CalceusHealth/sensor-skins-firmware/imports/alex_jira_duplicates/firmware/Reid Orthotic v2 Charger Mech/Charger case.step

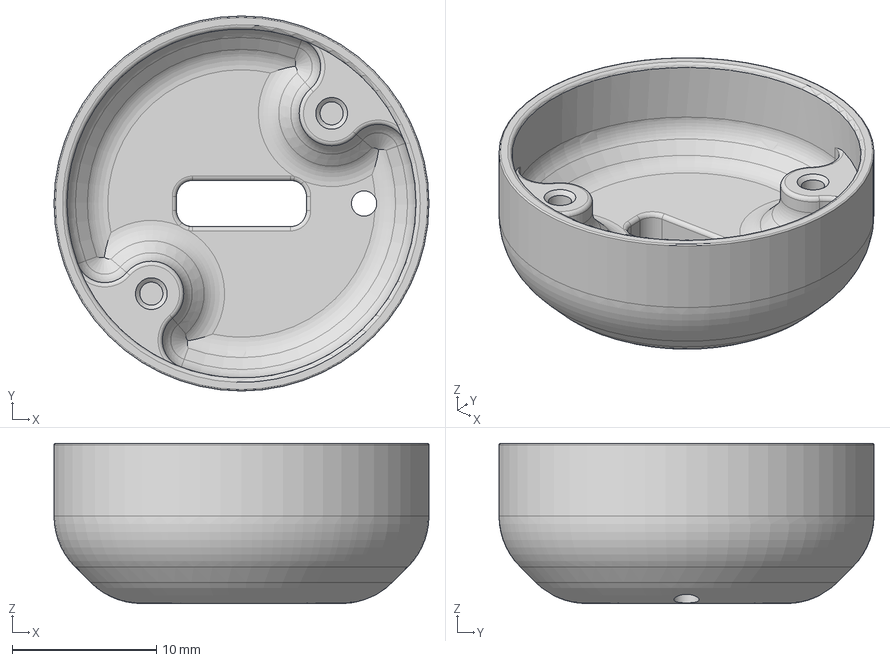
[picture p2: CAD file, 2026-04-29]
imports/alex_jira_duplicates/firmware/Reid Orthotic v2 Charger Mech/Charger case.step
26.0 x 26.0 x 11.1 mm
