CalceusHealth/sensor-skins-firmware/imports/alex_jira_duplicates/firmware/Reid Orthotic v2 Charger Mech/Charger lid.step

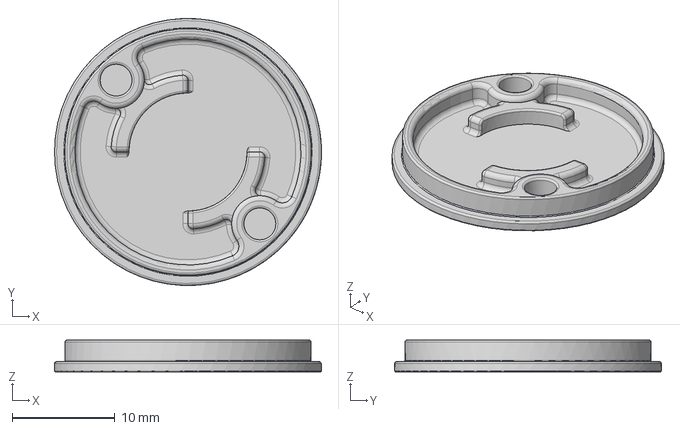
[picture p3: CAD file, 2026-04-29]
imports/alex_jira_duplicates/firmware/Reid Orthotic v2 Charger Mech/Charger lid.step
26.0 x 26.0 x 3.10 mm
