CalceusHealth/sensor-skins-firmware/(list of files, cad)

Other CAD files:
imports/alex_jira_duplicates/firmware/Reid Orthotic v2 Charger Mech/Charger case.f3d
imports/alex_jira_duplicates/firmware/Reid Orthotic v2 Charger Mech/Charger lid.f3d
