CalceusHealth/sensor-skins-firmware/artefacts/Reid Orthotic v2 R4.pdf

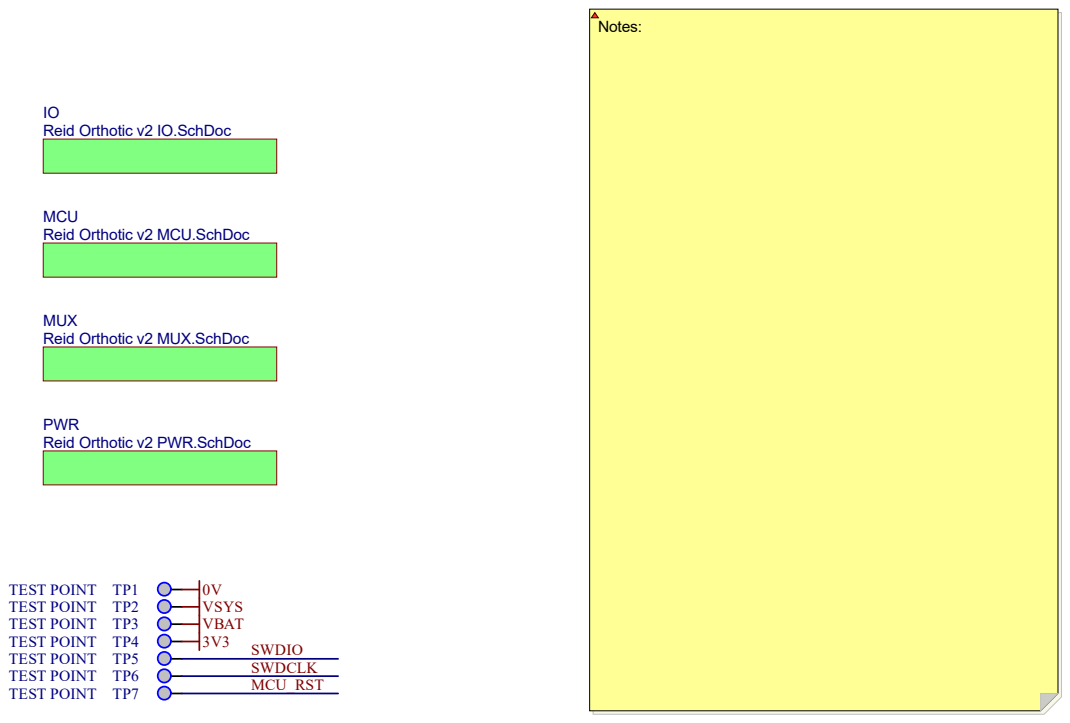
[picture p4: page 1]
Last u; ted 3/01/2024; 2Alex G; OReid Orthotic; Reid Orthotic; EST POIN; EST POIN EST POIN EST POIN EST POIN; COTP5 PITP50TP; NLMCU0RST PITP60TP; NLSWDCLK PITP50TP; NLSWDIO

CAL1020 Revision Drawn by

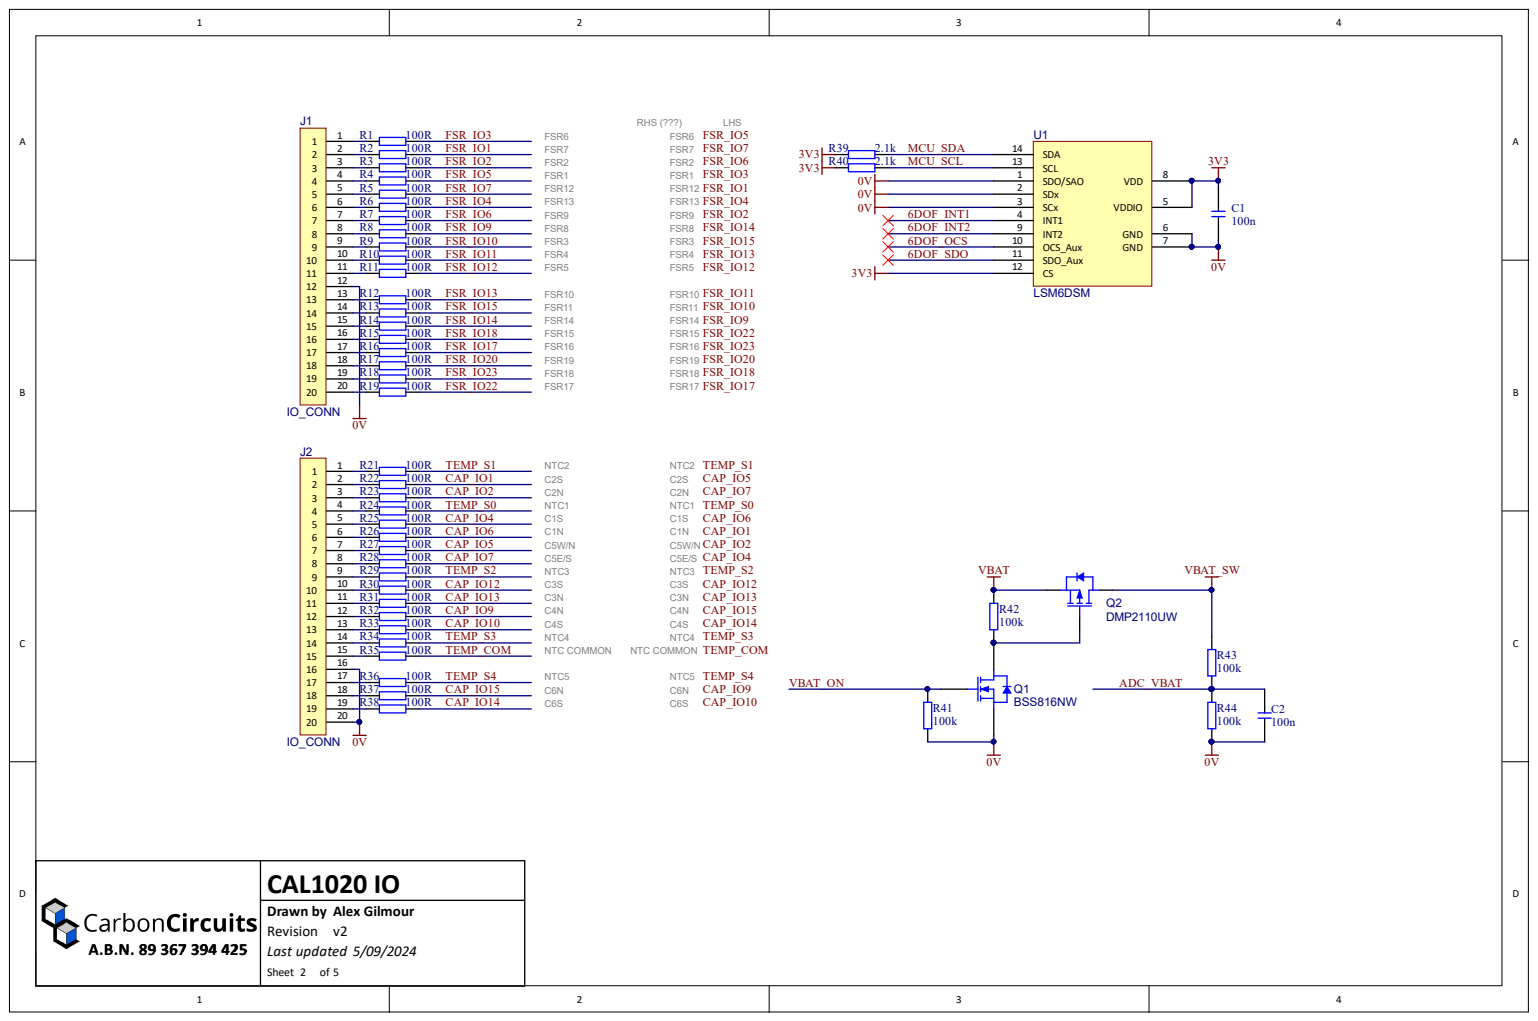
[picture p5: page 2]

CAL1020 IO Revision Drawn by

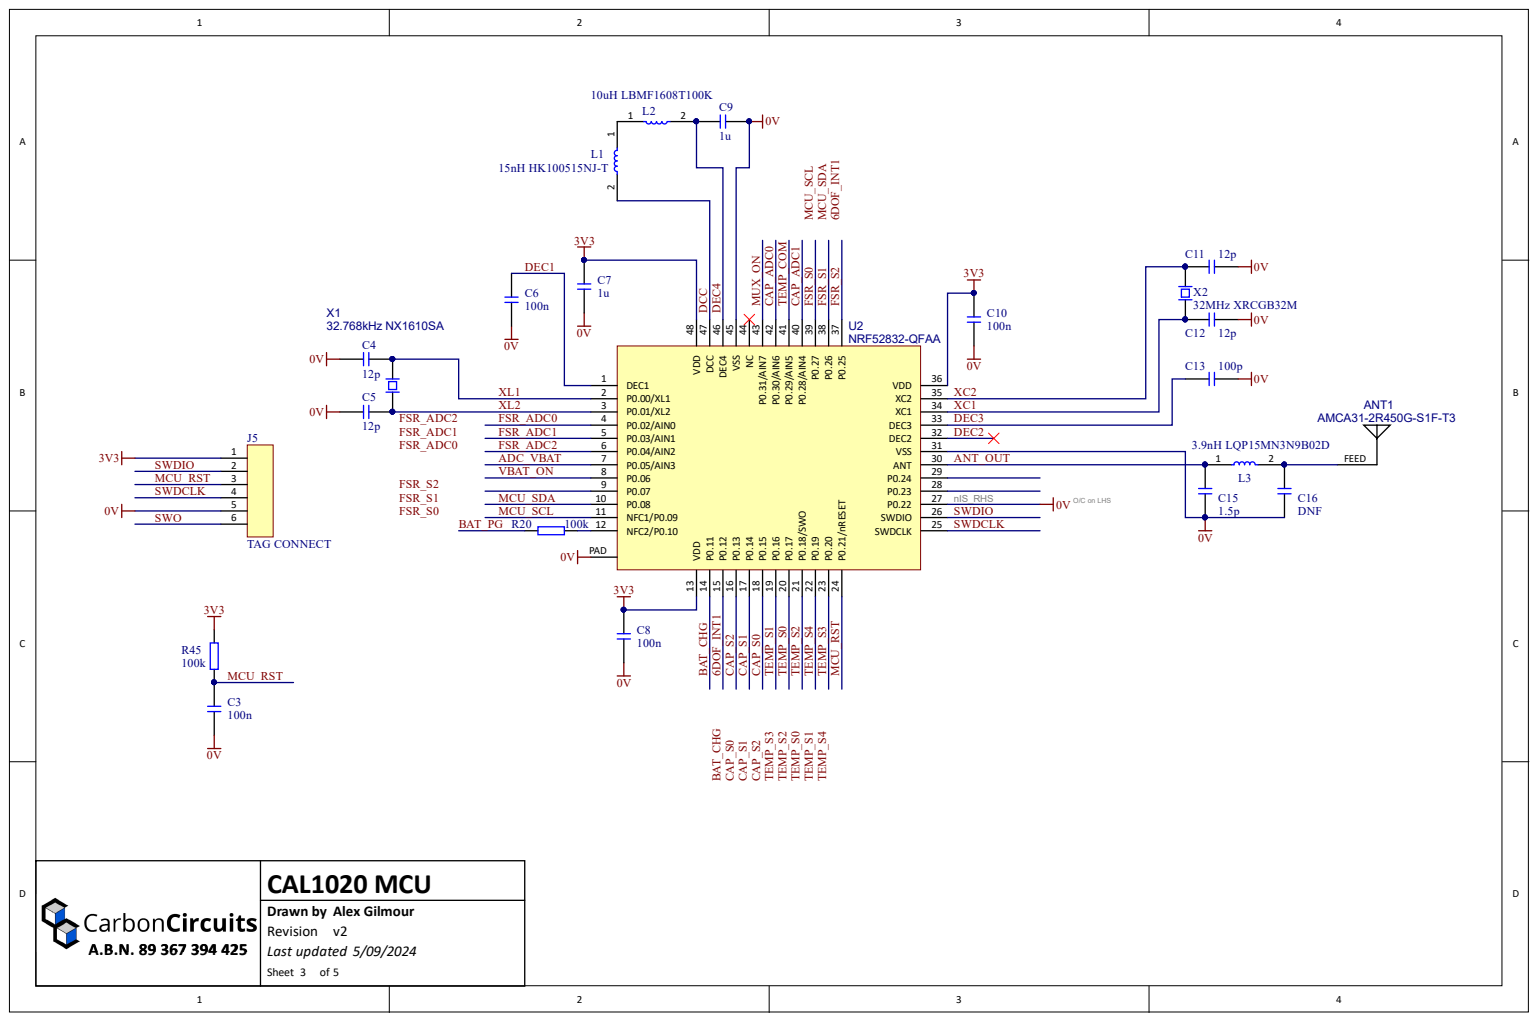
[picture p6: page 3]

0.25 37 P0.26 38 P0.27 39 P0.28/AIN4 40 P0.29/AIN5 41 P0.30/AIN6 42 P0.31/AIN7 43 NC 44 VSS 45 DEC4 46 DCC 47 VDD 48

CAL1020 MCU Revision Drawn by

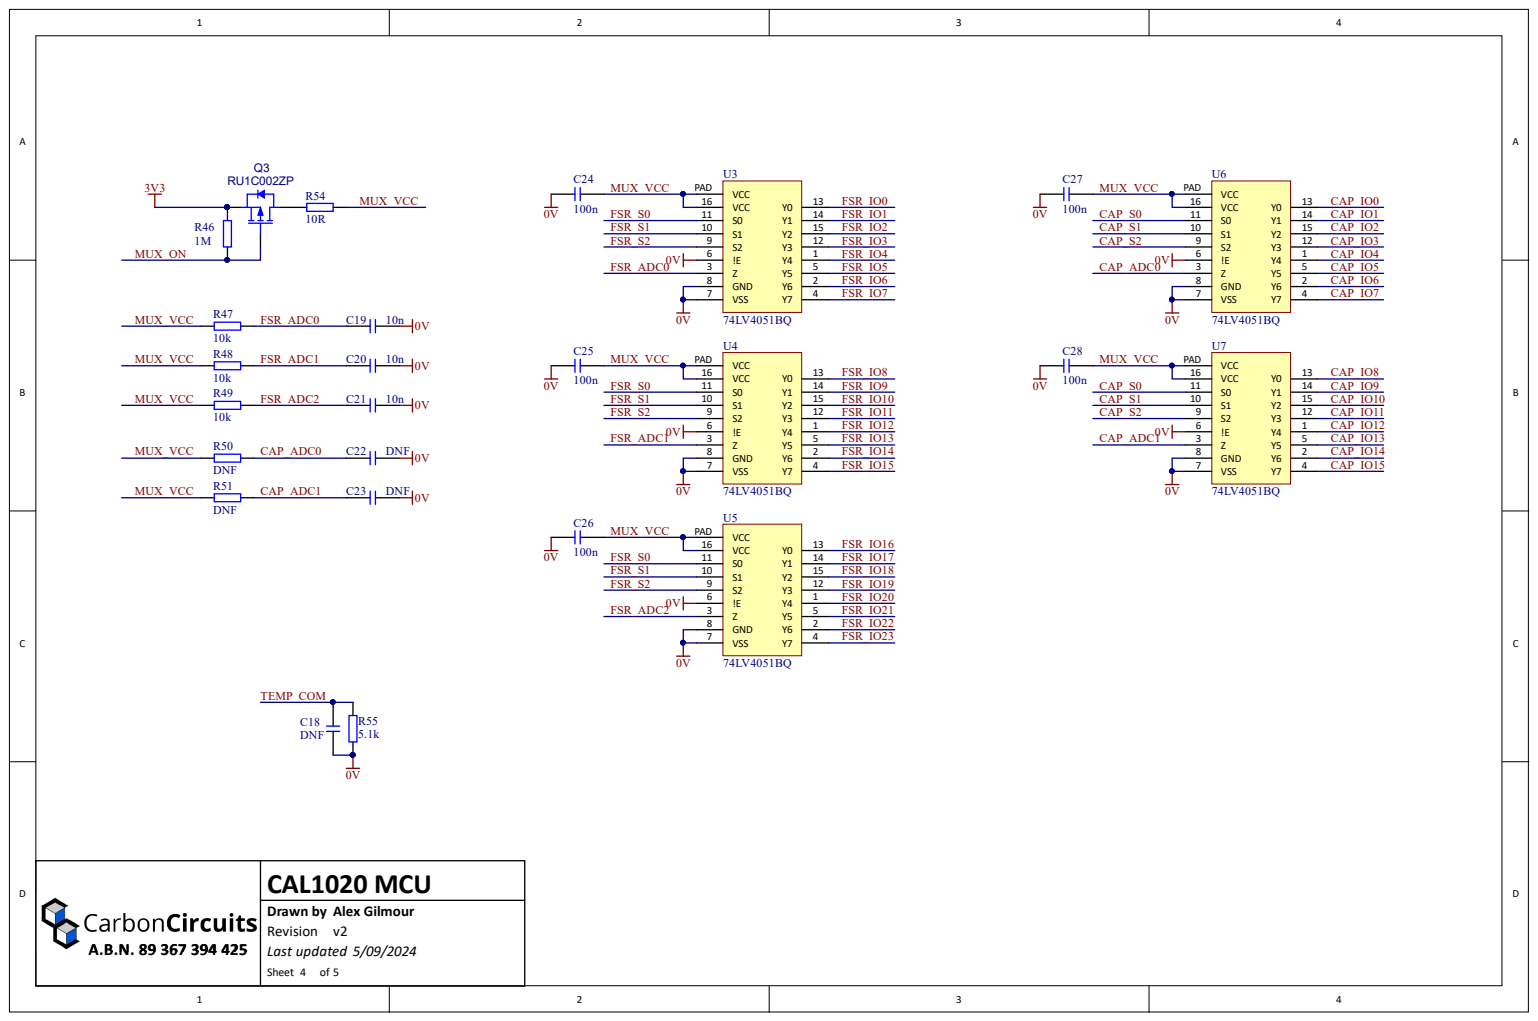
[picture p7: page 4]
Last u; ted 5/09/2024; 2Alex G; GND 8; n FSR_S0; n CAP_S0; V CAP_ADC1; DNF

CAL1020 MCU Revision Drawn by

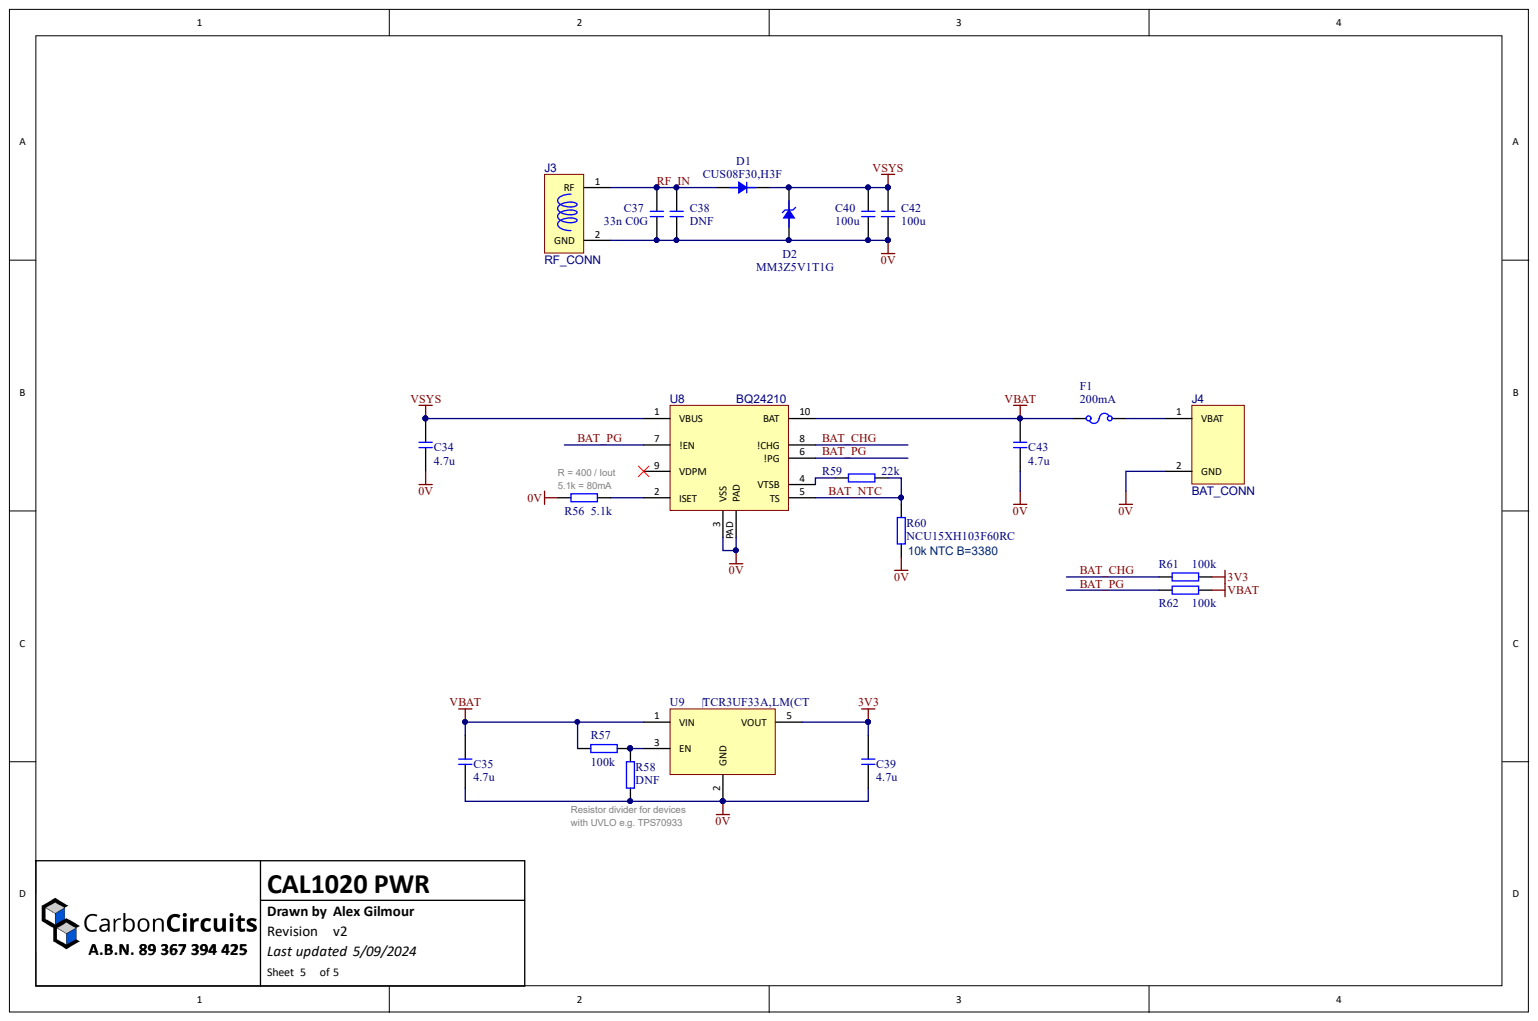
[picture p8: page 5]

Resistor divider for devices
with UVLO e.g. TPS70933

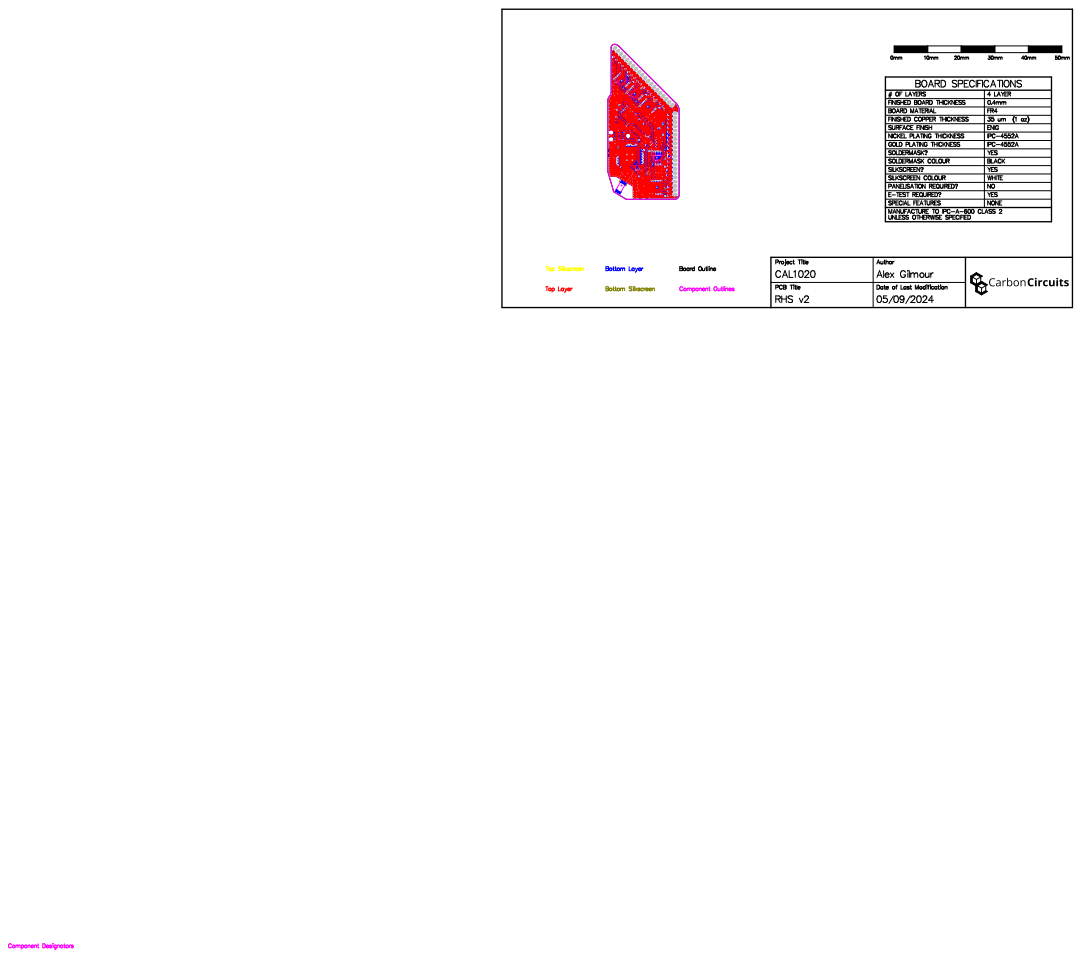
[picture p9: page 6]
