CalceusHealth/sensor-skins-firmware/imports/alex_jira_duplicates/firmware/Reid Orthotic v2 Charger R2.PDF

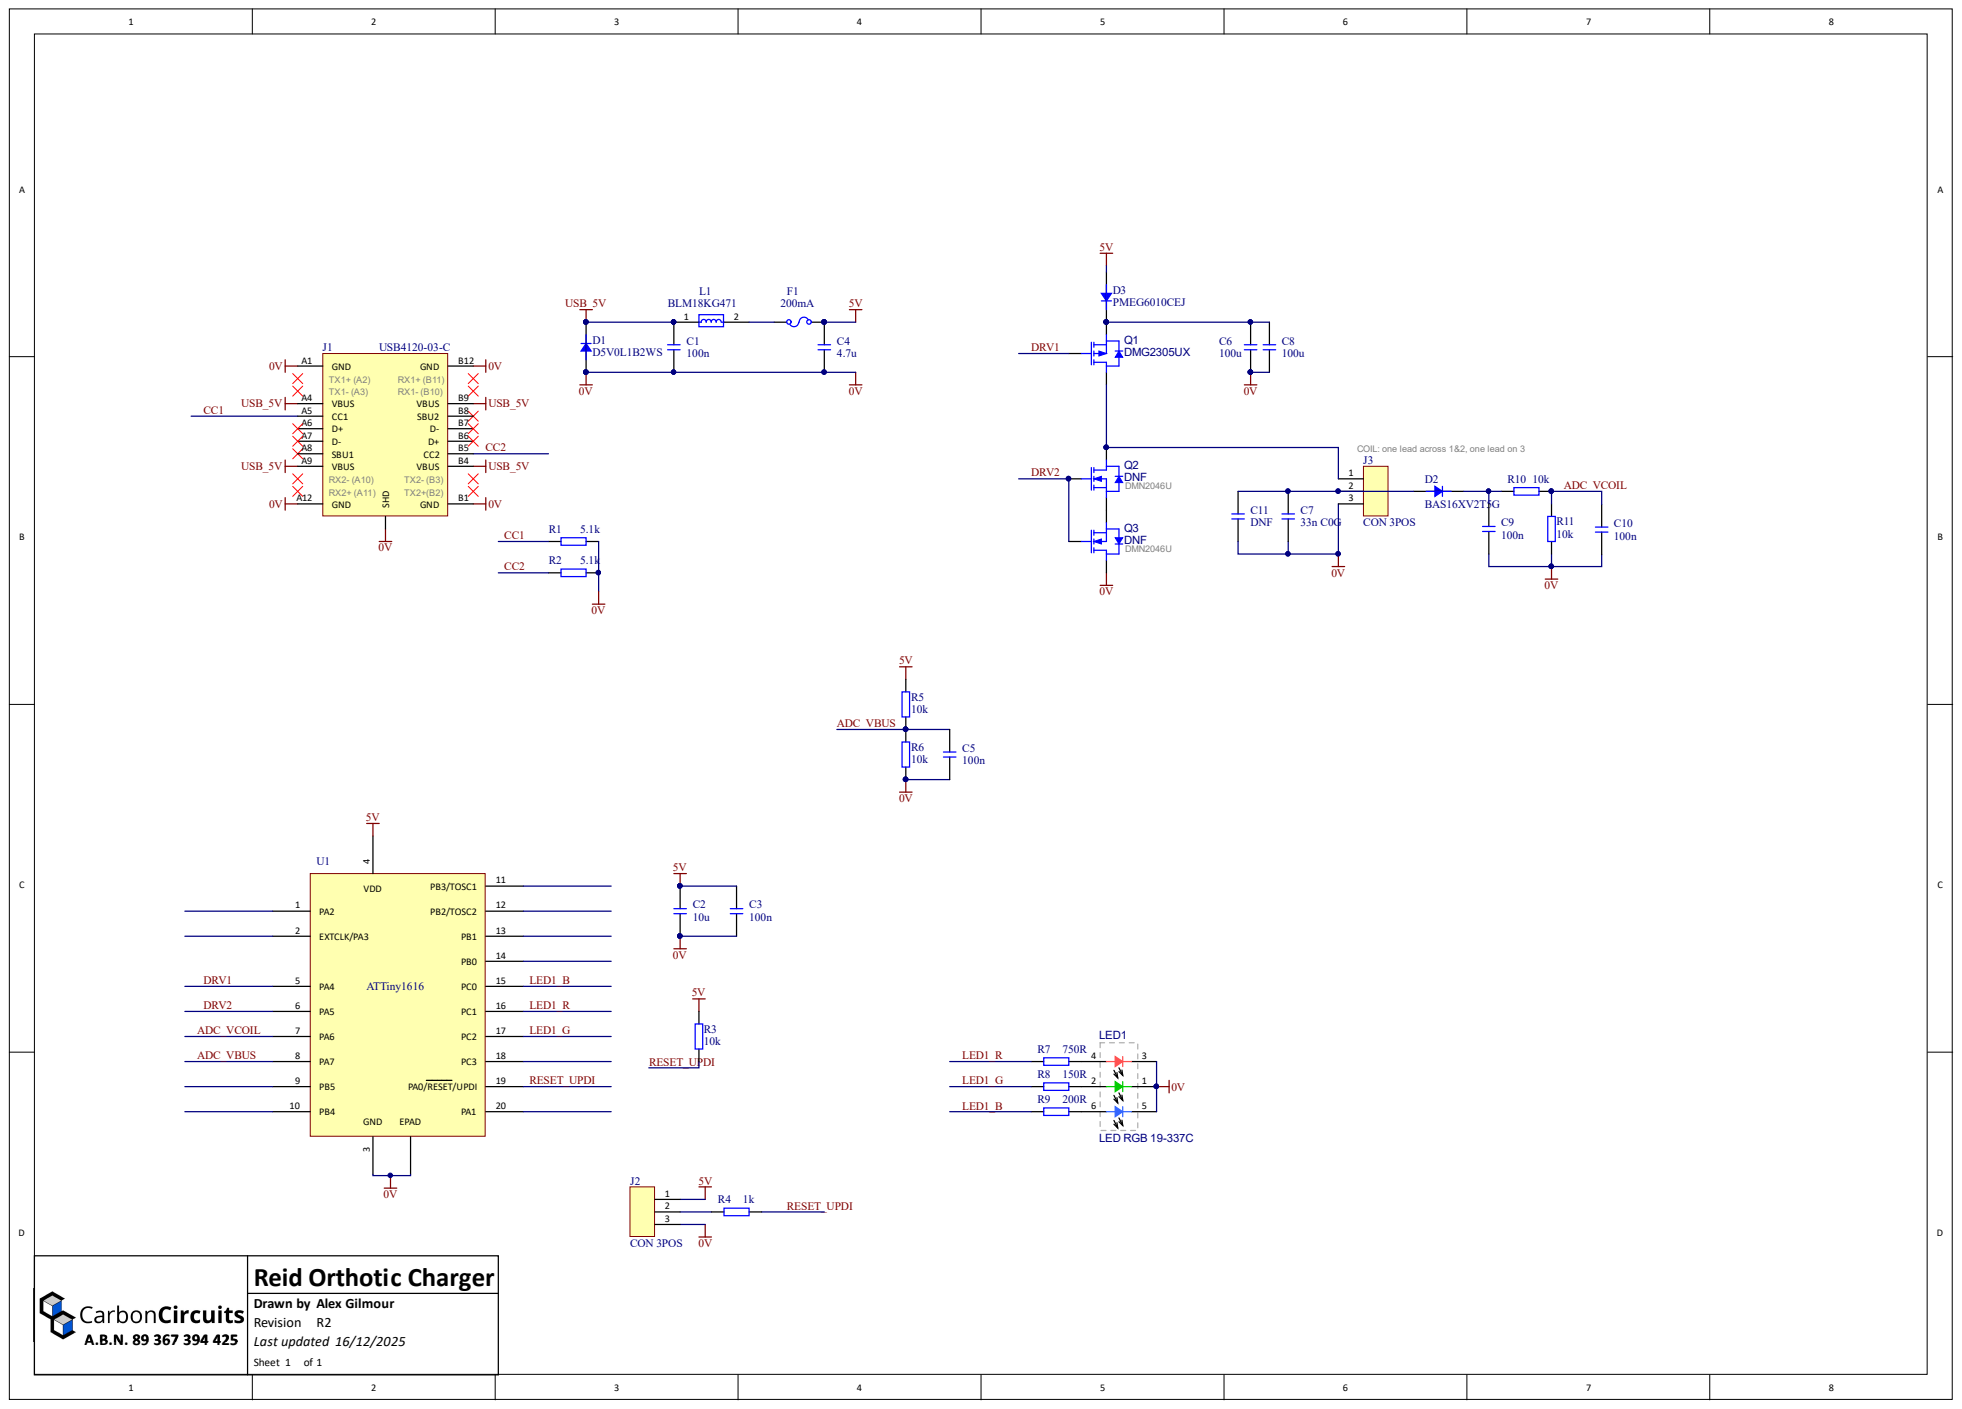
[picture p10: page 1]

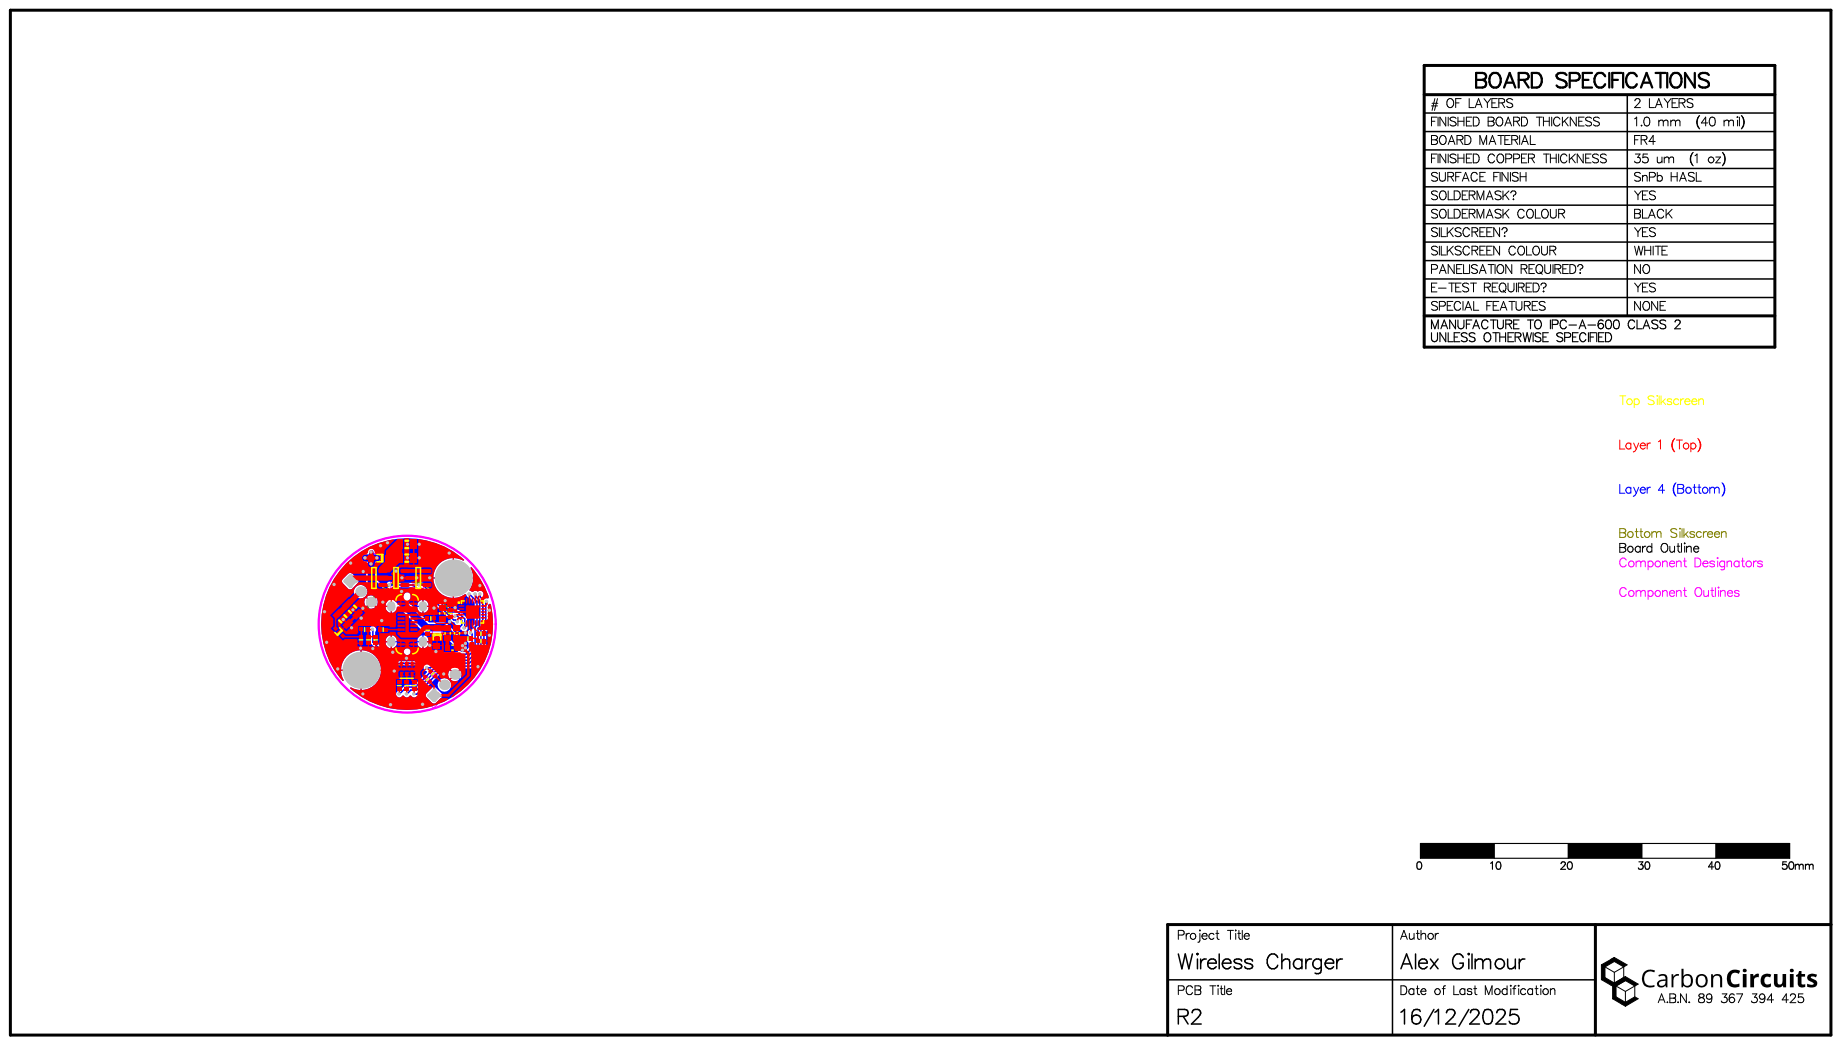
[picture p11: page 2]
