CalceusHealth/sensor-skins-firmware/(list of files, drawings)

Other design files:
imports/alex_jira_duplicates/firmware/Reid Orthotic v2 Charger R2 Design Files/Reid Orthotic v2 Charger.PcbLib
imports/alex_jira_duplicates/firmware/Reid Orthotic v2 Charger R2 Design Files/Reid Orthotic v2 Charger.PrjPcb
imports/alex_jira_duplicates/firmware/Reid Orthotic v2 Charger R2 Design Files/Reid Orthotic v2 Charger.SchDoc
imports/alex_jira_duplicates/firmware/Reid Orthotic v2 Charger R2 Design Files/Reid Orthotic v2 Charger.SchLib
