CalceusHealth/sensor-skins-firmware/firmware/Reid Orthotic v2 Charger Firmware R4/main.h

/*===========================================
//
// main.h
// Written by Alex Gilmour
// Copyright (c) 2024 CarbonCircuits
// All rights reserved.
//
//=========================================*/

#ifndef __MAIN_H
#define __MAIN_H

#include <stdint.h>

int main(void);

#endif // __MAIN_H
