CalceusHealth/sensor-skins-firmware/(commit log)

2026-04-29 Add Tim firmware branch sources, tooling, and docs
    [SensorSkinsBatteryTesting.csv]
2026-04-29 Move duplicate Alex imports into staging folder
    [Charger case.f3d, Charger case.step, Charger lid.f3d, Charger lid.step, Reid Orthotic v2 Charger.PcbLib, Reid Orthotic v2 Charger.PrjPcb, Reid Orthotic v2 Charger.SchDoc, Reid Orthotic v2 Charger.SchLib]
2026-05-01 Track firmware variants and add binary stream scaffold
2026-05-01 Pin v00020023 build matrix to release commit
2026-05-04 Add watchdog timer to recover from frozen sleep states
    Without a WDT, if the firmware stalls in WFE (e.g. RTC peripheral stops
    responding, or any non-hardfault hang) the chip stays alive but never
    reaches measure_sensors() or restarts advertising. Charging does not
    recover from this state -- only a full battery drain triggers POR.
    WDT runs during CPU sleep with a 60-second timeout. system_wdt_kick()
    is called at the top of system_sleep() so any stalled WFE loop that goes
    60s without an interrupt triggers a clean reset, and main() restarts
    BLE advertising on reboot.
    Adapted from claude-branch commit 1f7719e (originally targeted Alex's
    reid_ble_aginic_v2.07_source/ baseline; applied here to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
    [system.c, system.h]
2026-05-04 Increase recharge coil PWM duty cycle from 25 to 75 in R3 charger
    coil_set_power(25) drove the coil at ~10.5% duty cycle, well below the
    hardware ceiling. coil_set_power(75) gives ~31.6% duty (~3x more power
    transfer) and significantly reduces battery recharge time. A weak puck
    output is the leading hypothesis for several devices entering the
    'dark, charged, but not advertising' state -- a brief VSYS collapse
    during charging with the previous puck duty cycle could damage the 3V3
    LDO, MUX_VCC switching, or other components on the device PCB.
    Max supported by current PWM config is coil_set_power(100) (~43.9% duty).
    Validate thermal performance on hardware before going higher than 75.
    Adapted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
    [main.c]
2026-05-04 Add BLE 'lifeline' slow advertising during sleep states
    Previously enter_device_sleep() called ble_reid_force_disconnect() which
    stopped advertising entirely. Combined with the FSR-only wake conditions
    in the sleep loop, a device that enters sleep while not being worn
    (e.g. on the charger after the 15-second charging-confirmed idle window)
    becomes invisible to nRF Connect and the mobile app -- recoverable only
    by standing on the orthotic. This blocks bench diagnosis and field
    support entirely.
    This change keeps the device discoverable in BLE while in the sleep
    loop, at negligible power cost:
    ble_reid.c:
    - Enable BLE_ADV_MODE_SLOW alongside fast advertising in the
    ble_advertisin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
2026-05-04 Bump DEVICE_FW_VERSION to v00020024
    Includes watchdog (9f7999f), coil PWM 25->75 (fe16f70), and BLE
    lifeline (3d6b019). Distinct from v00020023 which had none of these
    firmware-resilience changes.
2026-05-22 Wire up LSM6DSM IMU bring-up (v00020025)
    Wake the previously-unwired LSM6DSM over I2C in main_init() via
    i2c_init()+lsm6dsm_init(), add lsm6dsm_whoami() plus WHO_AM_I defines,
    boot and per-loop RTT logging of the IMU sample, and a new ';QD'
    BLE/serial query returning WHO_AM_I + a fresh accel/gyro/temp sample.
    Bump DEVICE_FW_VERSION to 0x00020025 and record the build in the
    firmware build matrix. Source only; not yet built or flashed.
2026-05-22 Add Reid Orthotic v2 Charger Firmware R4 source
2026-05-22 Add serial protocol docs, sample-rate analysis, binary-stream handoff
    Also ignore local working artefacts (claude-status.md, session-data/, pins.png).
2026-06-03 Revert "Wire up LSM6DSM IMU bring-up (v00020025)"
    This reverts commit f6d7ca9ae6d7778bc31c2190380523605f842107.
    [configure_firmware.h, lsm6dsm.c, lsm6dsm.h, main.c, messaging.c, messaging_defines.h]
2026-06-03 Reset vbat moving average on recharge jump (v00020026)
    battery_update() kept a 10-deep moving average of vbat and only replaced
    one slot per update, with the buffer seeded just once at boot. After an
    overnight charge the average still held the pre-charge low samples and
    washed them out one slot at a time, so the reported voltage (and the
    app's derived %) climbed gradually over minutes instead of reflecting
    the real charged level.
    Reseed the whole buffer when a fresh reading jumps >150 mV above the
    running average (a recharge). Upward-only, so genuine discharge stays
    smoothed. Bump DEVICE_FW_VERSION 0x00020024 -> 0x00020026.
    Built/tested on top of the deployed v00020024 line (IMU bring-up l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
    [battery.c, configure_firmware.h]
2026-06-03 Add v00020026 stream DFU packages + matrix/branch-model update
    Record the battery-fix build (v00020026, stream LHS/RHS) in the build
    matrix and document the new branch model: main = Alex's baseline,
    tim = stable test line, experimental = IMU / sample-rate POC. Note the
    IMU build blocker (7-arg NRF_LOG_INFO) for when that track resumes.
2026-06-03 Add 2026-06-03 session handoff (battery reseed fix + branch model)
    Document the v00020026 battery moving-average reseed fix, the
    main/tim/experimental branch model, and the open IMU build blocker
    (7-arg NRF_LOG_INFO) on experimental.
2026-06-04 Add GitHub Actions workflow to build + publish Sensor Skins DFU packages
    Builds the R7 application for all live variants ({lhs,rhs} x {stream,nostream},
    sleep on) on an Ubuntu runner using the existing tools/*.sh scripts: downloads
    and caches the nRF5 SDK 15.3.0 and SEGGER Embedded Studio (free Nordic edition,
    emBuild needs no license), installs nrfutil, signs the DFU zips, and publishes
    them.
    Outputs are uploaded as workflow artifacts on every run, and on tim pushes a
    GitHub Release is created with the signed *_sensorskins.zip DFU packages (plus
    .hex) attached as direct-download assets for in-field flashing.
    The DFU signing key is .gitignored, so the workflow reads it from the
    CALCEUS_DFU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
